netz39/cyberdesk/hardware/control-panel/control-panel.step

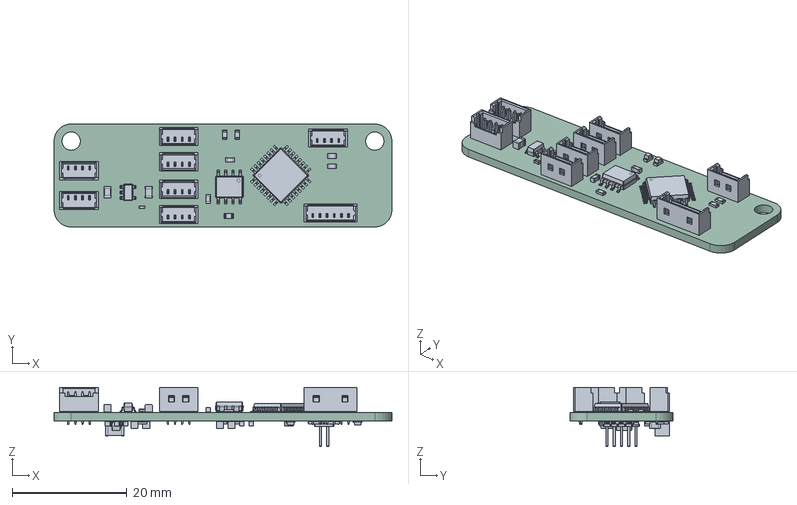
[picture p1: CAD file, 2025-11-06]
hardware/control-panel/control-panel.step
59.0 x 18.0 x 10.4 mm
R_0603_1608Metric x 9
C_0603_1608Metric x 9
C_0805_2012Metric x 6
SOIC-8_3.9x4.9mm_P1.27mm
SOT-23-5
LED_0603_1608Metric x 2
C_0402_1005Metric
LQFP-32_7x7mm_P0.8mm
SOT-23-6
D_SOD-523 x 4
L_1210_3225Metric
PinHeader_2x05_P1.27mm_Vertical_SMD
control-panel_PCB
