netz39/cyberdesk/hardware/extra3DModels/530470410.stp

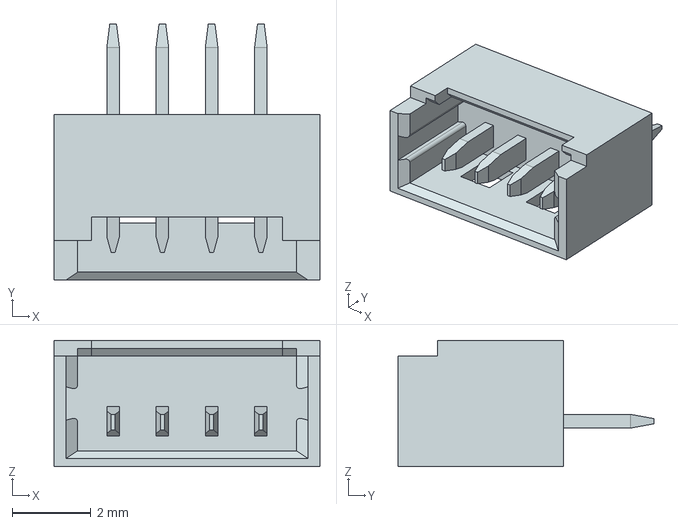
[picture p2: CAD file, 2025-11-06]
hardware/extra3DModels/530470410.stp
6.75 x 6.50 x 3.20 mm
