netz39/cyberdesk/hardware/extra3DModels/530470610.stp

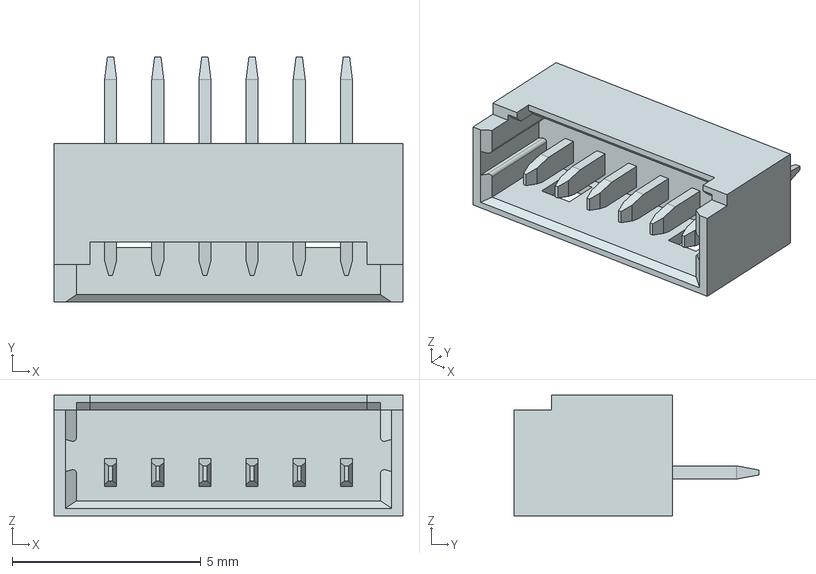
[picture p3: CAD file, 2025-11-06]
hardware/extra3DModels/530470610.stp
9.25 x 6.50 x 3.20 mm
