netz39/cyberdesk/hardware/control-panel/control-panel.kicad_pcb

## KiCad design hardware/control-panel/control-panel.kicad_pcb (2025-11-06)

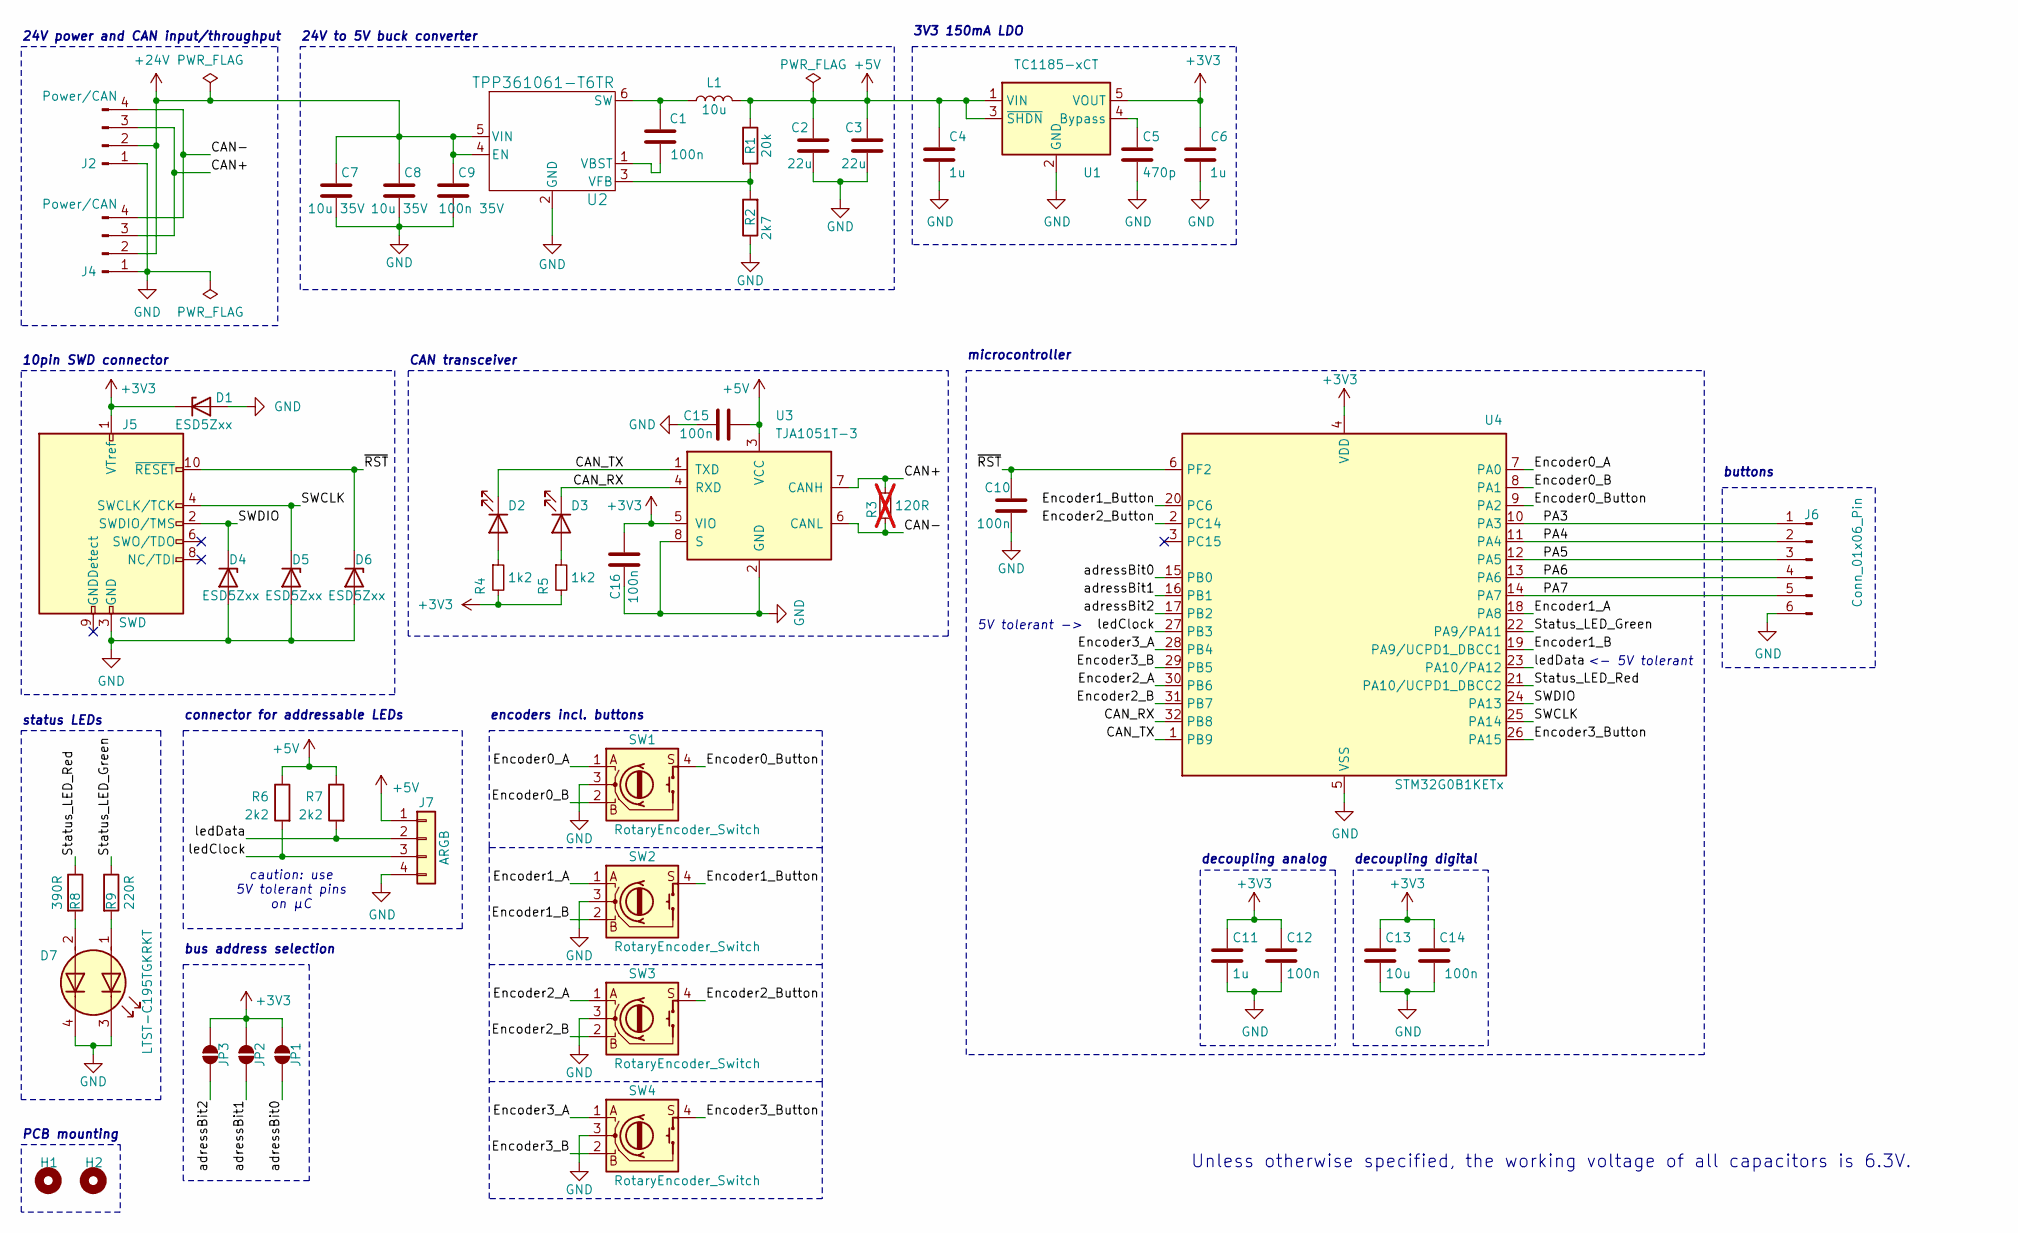
[picture p4: schematic control-panel.kicad_sch]

Parts:
C1, C10, C12, C14, C15, C16: 100n; C_0603_1608Metric_Pad1.08x0.95mm_HandSolder
C2, C3: 22u; C_0805_2012Metric_Pad1.18x1.45mm_HandSolder
C4, C6, C11: 1u; C_0805_2012Metric_Pad1.18x1.45mm_HandSolder
C5: 470p; C_0402_1005Metric_Pad0.74x0.62mm_HandSolder
C7, C8: 10u 35V; C_0603_1608Metric_Pad1.08x0.95mm_HandSolder
C9: 100n 35V; C_0603_1608Metric_Pad1.08x0.95mm_HandSolder
C13: 10u; C_0805_2012Metric_Pad1.18x1.45mm_HandSolder
D1, D4, D5, D6: ESD5Zxx; D_SOD-523
D2, D3: 150060BS75000; LED_0603_1608Metric_Pad1.05x0.95mm_HandSolder
D7: LTST-C195TGKRKT; LED_LiteOn_LTST-C195TGKRKT
H1, H2: MountingHole; MountingHole_3.2mm_M3_ISO14580
J2, J4: Power/CAN; Molex_PicoBlade_53047-0410_1x04_P1.25mm_Vertical
J5: SWD; PinHeader_2x05_P1.27mm_Vertical_SMD
J6: Conn_01x06_Pin; Molex_PicoBlade_53047-0610_1x06_P1.25mm_Vertical
J7: ARGB; Molex_PicoBlade_53047-0410_1x04_P1.25mm_Vertical
JP1, JP2, JP3: SolderJumper_2_Open; SolderJumper-2_P1.3mm_Open_TrianglePad1.0x1.5mm
L1: 10u; L_1210_3225Metric_Pad1.42x2.65mm_HandSolder
R1: 20k; R_0603_1608Metric_Pad0.98x0.95mm_HandSolder
R2: 2k7; R_0603_1608Metric_Pad0.98x0.95mm_HandSolder
R3: 120R; R_0603_1608Metric_Pad0.98x0.95mm_HandSolder; not fitted
R4, R5: 1k2; R_0603_1608Metric_Pad0.98x0.95mm_HandSolder
R6, R7: 2k2; R_0603_1608Metric_Pad0.98x0.95mm_HandSolder
R8: 390R; R_0603_1608Metric_Pad0.98x0.95mm_HandSolder
R9: 220R; R_0603_1608Metric_Pad0.98x0.95mm_HandSolder
SW1, SW2, SW3, SW4: RotaryEncoder_Switch; Molex_PicoBlade_53047-0410_1x04_P1.25mm_Vertical
U1: TC1185-xCT; SOT-23-5_HandSoldering
U2: TPP361061-T6TR; SOT-23-6_Handsoldering
U3: TJA1051T-3; SOIC-8_3.9x4.9mm_P1.27mm
U4: STM32G0B1KETx; LQFP-32_7x7mm_P0.8mm

Connections:
+3V3: C6.1, C11.1, C12.1, C13.2, C14.2, C16.1, D1.1 (K), J5.1 (VTref), JP1.1 (A), JP2.1 (A), JP3.1 (A), R4.2, R5.2, U1.5 (VOUT), U3.5 (VIO), U4.4 (VDD)
+5V: C2.2, C3.2, C4.1, C15.1, J7.1, L1.2, R1.1, R6.1, R7.1, U1.1 (VIN), U1.3 (~SHDN), U3.3 (VCC)
+24V: C7.2, C8.2, C9.2, J2.2, J4.2, U2.4 (EN), U2.5 (VIN)
/CAN+: J2.3, J4.3, R3.1, U3.7 (CANH)
/CAN-: J2.4, J4.4, R3.2, U3.6 (CANL)
/CAN_RX: D3.1 (K), U3.4 (RXD), U4.32 (PB8)
/CAN_TX: D2.1 (K), U3.1 (TXD), U4.1 (PB9)
/Encoder0_A: SW1.1 (A), U4.7 (PA0)
/Encoder0_B: SW1.2 (B), U4.8 (PA1)
/Encoder0_Button: SW1.4 (S), U4.9 (PA2)
/Encoder1_A: SW2.1 (A), U4.18 (PA8)
/Encoder1_B: SW2.2 (B), U4.19 (PA9/UCPD1_DBCC1)
/Encoder1_Button: SW2.4 (S), U4.20 (PC6)
/Encoder2_A: SW3.1 (A), U4.30 (PB6)
/Encoder2_B: SW3.2 (B), U4.31 (PB7)
/Encoder2_Button: SW3.4 (S), U4.2 (PC14)
/Encoder3_A: SW4.1 (A), U4.28 (PB4)
/Encoder3_B: SW4.2 (B), U4.29 (PB5)
/Encoder3_Button: SW4.4 (S), U4.26 (PA15)
/PA3: J6.1, U4.10 (PA3)
/PA4: J6.2, U4.11 (PA4)
/PA5: J6.3, U4.12 (PA5)
/PA6: J6.4, U4.13 (PA6)
/PA7: J6.5, U4.14 (PA7)
/SWCLK: D5.1 (K), J5.4 (SWCLK/TCK), U4.25 (PA14)
/SWDIO: D4.1 (K), J5.2 (SWDIO/TMS), U4.24 (PA13)
/Status_LED_Green: R9.1, U4.22 (PA9/PA11)
/Status_LED_Red: R8.1, U4.21 (PA10/UCPD1_DBCC2)
/adressBit0: JP1.2 (B), U4.15 (PB0)
/adressBit1: JP2.2 (B), U4.16 (PB1)
/adressBit2: JP3.2 (B), U4.17 (PB2)
/ledClock: J7.3, R6.2, U4.27 (PB3)
/ledData: J7.2, R7.2, U4.23 (PA10/PA12)
/~RST: C10.1, D6.1 (K), J5.10 (~RESET), U4.6 (PF2)
GND: C2.1, C3.1, C4.2, C5.2, C6.2, C7.1, C8.1, C9.1, C10.2, C11.2, C12.2, C13.1, C14.1, C15.2, C16.2, D1.2 (A), D4.2 (A), D5.2 (A), D6.2 (A), D7.3 (K1), D7.4 (K2), J2.1, J4.1, J5.3 (GND), J5.5 (GND), J6.6, J7.4, R2.1, SW1.3 (C), SW2.3 (C), SW3.3 (C), SW4.3 (C), U1.2 (GND), U2.2 (GND), U3.2 (GND), U3.8 (S), U4.5 (VSS)
unnamed: D2.2 (A), R4.1
unnamed: D3.2 (A), R5.1
unnamed: D7.1 (A1), R9.2
unnamed: D7.2 (A2), R8.2
unnamed: C5.1, U1.4 (Bypass)
unnamed: C1.2, L1.1, U2.6 (SW)
unnamed: C1.1, U2.1 (VBST)
unnamed: R1.2, R2.2, U2.3 (VFB)

Notes on the sheet:
decoupling analog
encoders incl. buttons
3V3 150mA LDO
24V power and CAN input/throughput
microcontroller
CAN transceiver
PCB mounting
5V tolerant ->
connector for addressable LEDs
Unless otherwise specified, the working voltage of all capacitors is 6.3V.
status LEDs
buttons
bus address selection
24V to 5V buck converter
<- 5V tolerant
caution: use 5V tolerant pins on µC
10pin SWD connector
decoupling digital

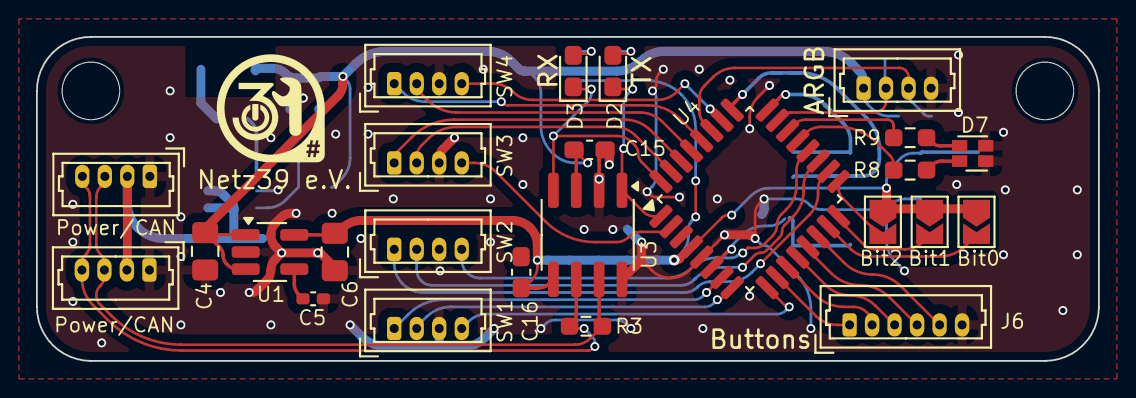
[picture p5: board control-panel.kicad_pcb from above]

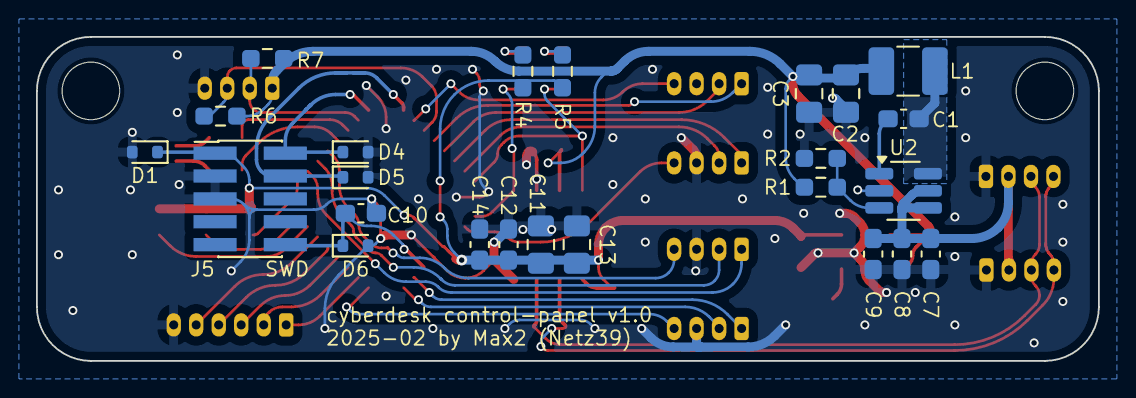
[picture p6: board control-panel.kicad_pcb from below]

Board: 2 copper layers, 59.0 x 18.0 mm, 51 parts (24 on the bottom side), 43 nets.
