netz39/cyberdesk/hardware/led-bar/led-bar.kicad_pcb

## KiCad design hardware/led-bar/led-bar.kicad_pcb (2025-02-23)

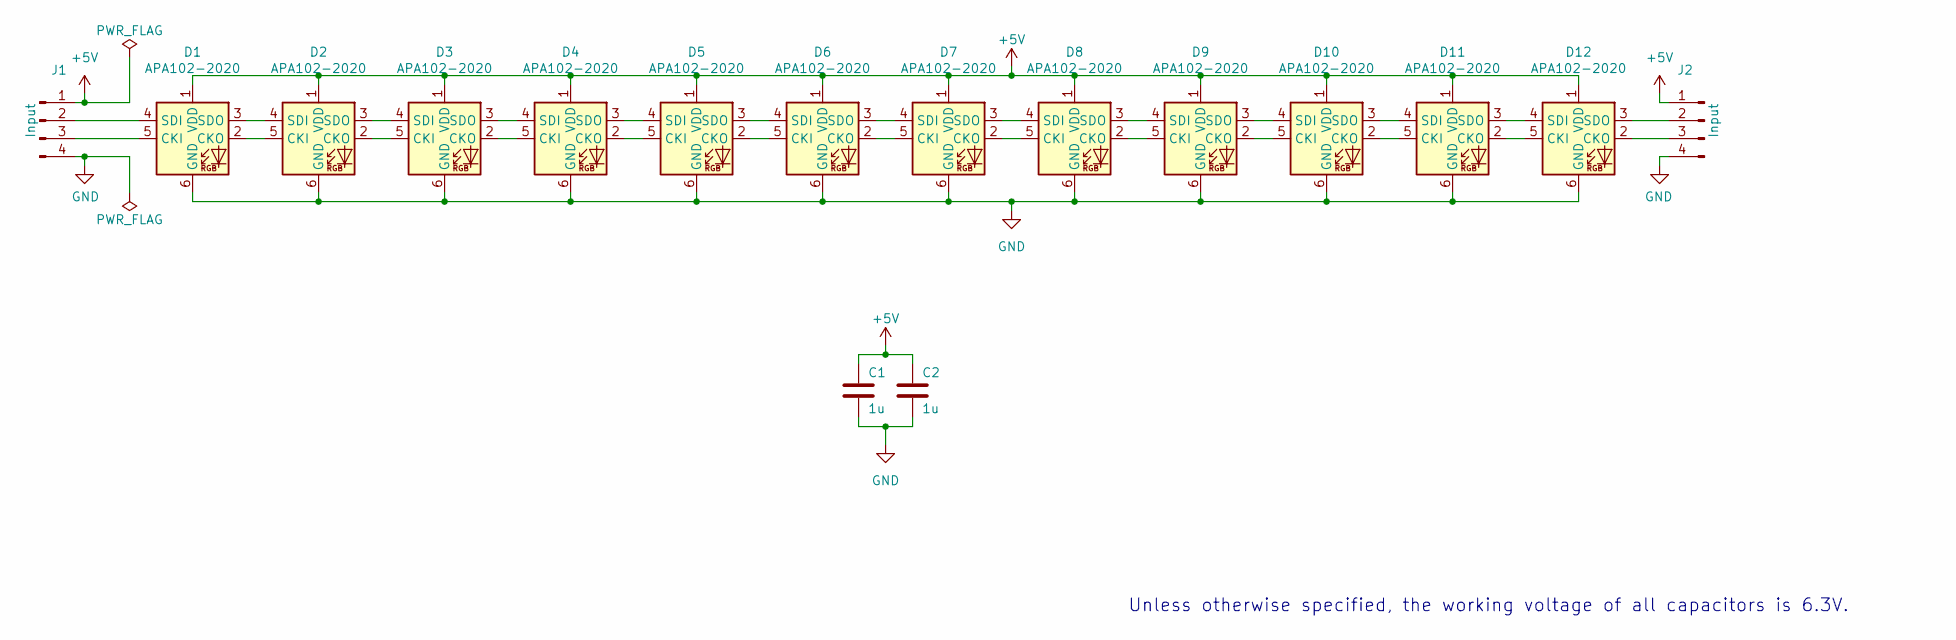
[picture p7: schematic led-bar.kicad_sch]

Parts:
C1, C2: 1u; C_0805_2012Metric_Pad1.18x1.45mm_HandSolder
D1, D2, D3, D4, D5, D6, D7, D8, D9, D10, D11, D12: APA102-2020; LED-APA102-2020
J1, J2: Input; SMD_4xSolderPads_2,5mm_1mm

Connections:
+5V: C1.1, C2.1, D1.1 (VDD), D2.1 (VDD), D3.1 (VDD), D4.1 (VDD), D5.1 (VDD), D6.1 (VDD), D7.1 (VDD), D8.1 (VDD), D9.1 (VDD), D10.1 (VDD), D11.1 (VDD), D12.1 (VDD), J1.1, J2.1
GND: C1.2, C2.2, D1.6 (GND), D2.6 (GND), D3.6 (GND), D4.6 (GND), D5.6 (GND), D6.6 (GND), D7.6 (GND), D8.6 (GND), D9.6 (GND), D10.6 (GND), D11.6 (GND), D12.6 (GND), J1.4, J2.4
unnamed: D1.5 (CKI), J1.3
unnamed: D1.2 (CKO), D2.5 (CKI)
unnamed: D1.4 (SDI), J1.2
unnamed: D1.3 (SDO), D2.4 (SDI)
unnamed: D2.2 (CKO), D3.5 (CKI)
unnamed: D2.3 (SDO), D3.4 (SDI)
unnamed: D3.2 (CKO), D4.5 (CKI)
unnamed: D3.3 (SDO), D4.4 (SDI)
unnamed: D4.2 (CKO), D5.5 (CKI)
unnamed: D4.3 (SDO), D5.4 (SDI)
unnamed: D5.2 (CKO), D6.5 (CKI)
unnamed: D5.3 (SDO), D6.4 (SDI)
unnamed: D6.2 (CKO), D7.5 (CKI)
unnamed: D6.3 (SDO), D7.4 (SDI)
unnamed: D7.2 (CKO), D8.5 (CKI)
unnamed: D7.3 (SDO), D8.4 (SDI)
unnamed: D8.2 (CKO), D9.5 (CKI)
unnamed: D8.3 (SDO), D9.4 (SDI)
unnamed: D9.2 (CKO), D10.5 (CKI)
unnamed: D10.2 (CKO), D11.5 (CKI)
unnamed: D9.3 (SDO), D10.4 (SDI)
unnamed: D10.3 (SDO), D11.4 (SDI)
unnamed: D11.2 (CKO), D12.5 (CKI)
unnamed: D11.3 (SDO), D12.4 (SDI)
unnamed: D12.2 (CKO), J2.3
unnamed: D12.3 (SDO), J2.2

Notes on the sheet:
Unless otherwise specified, the working voltage of all capacitors is 6.3V.

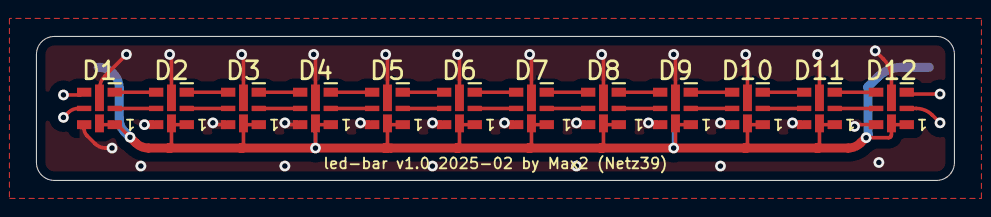
[picture p8: board led-bar.kicad_pcb from above]

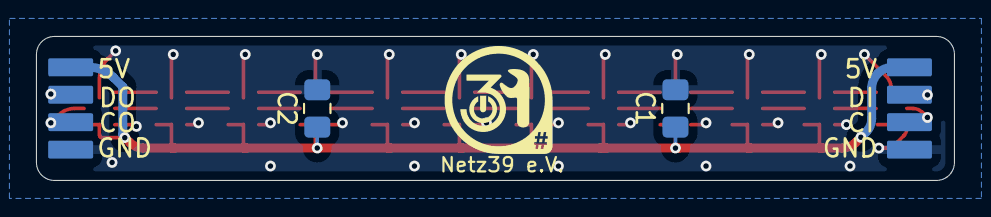
[picture p9: board led-bar.kicad_pcb from below]

Board: 2 copper layers, 51.0 x 8.0 mm, 16 parts (4 on the bottom side), 28 nets.
