netz39/cyberdesk/firmware/control-panel_firmware/control-panel_firmware.ioc

Mcu.UserName=STM32G0B1KETx
PA0.GPIO_Label=Encoder0_A
PA0.Signal=S_TIM2_CH1_ETR
PA1.GPIO_Label=Encoder0_B
PA1.Signal=S_TIM2_CH2
PA10.GPIO_Label=ledRed
PA10.Signal=S_TIM1_CH3
PA13.Signal=SYS_SWDIO
PA14-BOOT0.Signal=SYS_SWCLK
PA15.GPIO_Label=Encoder2_Button
PA15.Signal=GPIO_Input
PA2.GPIO_Label=Encoder0_Button
PA2.Signal=GPIO_Input
PA8.GPIO_Label=Encoder1_A
PA8.Signal=S_TIM1_CH1
PA9.GPIO_Label=Encoder1_B
PA9.Signal=S_TIM1_CH2
PB0.GPIO_Label=addressBit0
PB0.Signal=GPIO_Input
PB1.GPIO_Label=addressBit1
PB1.Signal=GPIO_Input
PB2.GPIO_Label=addressBit2
PB2.Signal=GPIO_Input
PB3.Signal=SPI1_SCK
PB4.GPIO_Label=Encoder2_A
PB4.Signal=S_TIM3_CH1
PB5.GPIO_Label=Encoder2_B
PB5.Signal=S_TIM3_CH2
PB6.GPIO_Label=Encoder3_A
PB6.Signal=S_TIM4_CH1
PB7.GPIO_Label=Encoder3_B
PB7.Signal=S_TIM4_CH2
PB8.Signal=FDCAN1_RX
PB9.Signal=FDCAN1_TX
PC6.GPIO_Label=Encoder1_Button
PC6.Signal=GPIO_Input
