netz39/cyberdesk/firmware/control-panel_firmware/cubemx/Core/Inc/main.h

#define Encoder2_Button_Pin GPIO_PIN_14
#define Encoder2_Button_GPIO_Port GPIOC
#define Encoder0_A_Pin GPIO_PIN_0
#define Encoder0_A_GPIO_Port GPIOA
#define Encoder0_B_Pin GPIO_PIN_1
#define Encoder0_B_GPIO_Port GPIOA
#define Encoder0_Button_Pin GPIO_PIN_2
#define Encoder0_Button_GPIO_Port GPIOA
#define addressBit0_Pin GPIO_PIN_0
#define addressBit0_GPIO_Port GPIOB
#define addressBit1_Pin GPIO_PIN_1
#define addressBit1_GPIO_Port GPIOB
#define addressBit2_Pin GPIO_PIN_2
#define addressBit2_GPIO_Port GPIOB
#define Encoder1_Button_Pin GPIO_PIN_6
#define Encoder1_Button_GPIO_Port GPIOC
#define ledRed_Pin GPIO_PIN_10
#define ledRed_GPIO_Port GPIOA
#define ledGreen_Pin GPIO_PIN_11
#define ledGreen_GPIO_Port GPIOA
#define Encoder3_Button_Pin GPIO_PIN_15
#define Encoder3_Button_GPIO_Port GPIOA
#define Encoder2_A_Pin GPIO_PIN_6
#define Encoder2_A_GPIO_Port GPIOB
#define Encoder2_B_Pin GPIO_PIN_7
#define Encoder2_B_GPIO_Port GPIOB
