netz39/cyberdesk/firmware/control-panel_firmware/src/encoder/Encoder.hpp

#pragma once

#include "gcem.hpp"
#include "helpers/freertos.hpp"
#include "util/Button.hpp"
#include "wrappers/Task.hpp"

#include "tim.h"

class Encoder
{
public:
    Encoder(TIM_HandleTypeDef *encoderTimer, util::Button &encoderButton, util::Button &powerButton) //
        : encoderTimer(encoderTimer),                                                                //
          encoderButton(encoderButton),                                                              //
          powerButton(powerButton)
    {
        configASSERT(encoderTimer != nullptr);
    }

    // ----------------------------------------------------------------------------
    void startEncoderDetection()
    {
        configASSERT(HAL_TIM_Encoder_Start(encoderTimer, TIM_CHANNEL_ALL) == HAL_OK);
    }

    // ----------------------------------------------------------------------------
    void handleButtonSampling(units::si::Time buttonSamplingInterval)
    {
        encoderButton.update(buttonSamplingInterval);
        powerButton.update(buttonSamplingInterval);
    }

    // ----------------------------------------------------------------------------
    int getEncoderDelta()
    {
        constexpr auto ElectricalStepsPerMechanicalStep = 4;

        const uint16_t EncoderValue = __HAL_TIM_GET_COUNTER(encoderTimer);
        int diff = (EncoderValue - prevEncoderValue);

        if (diff == 0 || gcem::abs(diff) < ElectricalStepsPerMechanicalStep)
            return 0;

        // handle underflow (transition 0 -> 65535)
        if (diff >= std::numeric_limits<uint16_t>::max() / 2)
            diff = -1 * (std::numeric_limits<uint16_t>::max() - diff + 1);

        // handle overflow (transition 65535 -> 0)
        else if (diff <= -std::numeric_limits<uint16_t>::max() / 2)
            diff = std::numeric_limits<uint16_t>::max() + diff + 1;

        // check if the encoder has been moved by at least one mechanical step
        if (gcem::abs(diff) < ElectricalStepsPerMechanicalStep)
            return 0;

        diff = (diff / ElectricalStepsPerMechanicalStep);
        prevEncoderValue = EncoderValue;

        return diff;
    }

    // ----------------------------------------------------------------------------
    void assignEncoderButtonCallback(std::function<void(util::Button::Action)> callback)
    {
        encoderButton.setCallback(callback);
    }

    // ----------------------------------------------------------------------------
    void assignPowerButtonCallback(std::function<void(util::Button::Action)> callback)
    {
        powerButton.setCallback(callback);
    }

private:
    TIM_HandleTypeDef *encoderTimer = nullptr;
    util::Button &encoderButton;
    util::Button &powerButton;

    uint16_t prevEncoderValue = 0;
};
