netz39/cyberdesk/(commit log)

2025-02-07 Init project
    [LED_lowSide_driver.kicad_sch, control-panel.kicad_pcb, control-panel.kicad_sch, light-driver.kicad_pcb, light-driver.kicad_sch]
2025-02-09 Finish light-driver hardware
    [light-driver.kicad_pcb, light-driver.kicad_sch]
2025-02-09 Finish control panel
    [control-panel.kicad_pcb, control-panel.kicad_sch]
2025-02-09 Create two subfolders to keep hardware and firmware separate
    [LED_lowSide_driver.kicad_sch, control-panel.kicad_pcb, control-panel.kicad_sch, light-driver.kicad_pcb, light-driver.kicad_sch]
2025-02-10 Update footprints to given in inventory
    [control-panel.kicad_pcb, control-panel.kicad_sch, light-driver.kicad_pcb, light-driver.kicad_sch]
2025-02-10 Add addressable LED bar
    [led-bar.kicad_pcb, led-bar.kicad_sch]
2025-02-10 Add notes
    [control-panel.kicad_sch, light-driver.kicad_sch]
2025-02-23 Update some values
    [control-panel.kicad_pcb, control-panel.kicad_sch, led-bar.kicad_pcb, light-driver.kicad_pcb, light-driver.kicad_sch]
2025-02-25 Init firmware projects with Hello-World LED blinking
2025-02-25 Add basic LED strip control
2025-02-26 Add fading for LED strip
2025-02-26 Control LED strip over CAN
2025-02-26 Use array for LED strips
2025-02-27 Add feedback bar with addressable LEDs
2025-02-27 Add fault handlers to malloc failed and stack overflow hooks
    [control-panel_firmware.ioc]
2025-02-27 Add encoder, state machine and CAN sender
2025-09-30 Improve UI handling by reducing from two encoder to single one, switch between brightness and color mode with encoder button. Turn on/off strip with dedicated power button.
2025-10-01 Deattach timers from unused encoders to use PWM for status LED
2025-10-04 Improve fading so each LED has individual fading window
2025-11-06 Add 3D model
    [530470410.stp, 530470610.stp, control-panel.kicad_pcb, control-panel.step]
2026-04-13 Reset brightness/color temperature after being off some time
    [StateMachine.hpp]
2026-04-13 Add .history (introduced by KiCad 10) to gitignore
